jahnavikuruvalli/tony-gesture-controlled-robotic-arm/docs/images/Screenshot 2026-07-26 at 3.52.04 PM.png

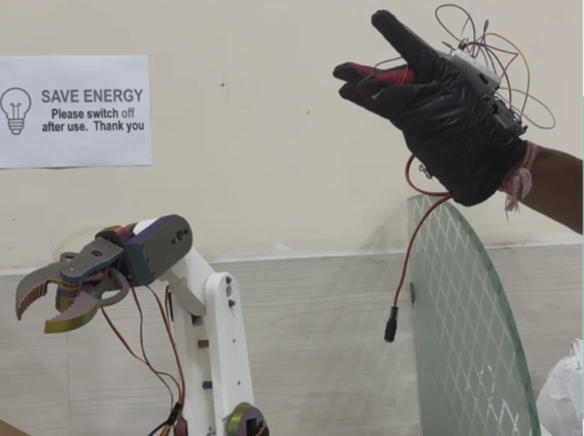
docs/images/Screenshot 2026-07-26 at 3.52.04 PM.png
